EmmanuelPons/MielTech/(commit log)

2025-04-08 Create code_final.ino
    ✨ Code final du prototype de ruche connectée
    - Lecture complète des capteurs : DHT22 (x2), DS18B20 (x2), HX711, luminosité, batterie
    - Conversion des mesures pour envoi compressé : int16_t (×10/×100), float pour batterie
    - Construction d’un payload compact (20 + 4 octets)
    - Transmission via LoRa (OTAA) vers TTN
    - Mise en veille prolongée via ArduinoLowPower (10 min)
    - Gestion du régulateur (SHDN) pour économie d’énergie
    Projet final MielTech — Polytech Sorbonne / Saint-Cyr-l’École
2025-04-08 Create payload_mieltech.js
    🧩 Ajout du décodeur TTN pour MielTech (payload_mieltech.js)
    - Décodage complet du payload LoRa uplink : 8 mesures en int16/uint16 + 1 float batterie
    - Lecture en little-endian pour int16, uint16 et float32
    - Conversion en unités réelles (température, humidité, poids, luminosité, batterie)
    - Ajout d’une clé BEEP pour intégration directe avec la plateforme
    - Gestion d’erreur si payload incomplet (< 20 octets)
    Script compatible TTN / TTS V3 — formaté pour affichage automatique dans les dashboards.
2025-04-08 Create README.md
    📝 Ajout du README.md complet du projet MielTech
    - Présentation générale du projet de ruche connectée LoRa
    - Détails des capteurs, microcontrôleur et fonctionnement
    - Description du code Arduino et structure du payload
    - Informations sur le décodeur TTN (payload_mieltech.js)
    - Références techniques et ressources utilisées
    - Arborescence du dépôt et étapes de reproduction du projet
